iamashwin99/Proj14/README.md

# Proj14
Project work for Microprocessor and Interfacing Course. Design of a Keypad based Door Security Control on a 8086 microprocessor.
