iamashwin99/Proj14/Design.pptx

## DOOR SECURITY CONTROL SYSTEM Submitted by: Group 14

Group Members
- Ashwin Kumar K (2017B5A81034G)
- Sharvari Hedaoo (2017B5A70593G)
- Shreyas Nisal (2017B5A70310G)
- Vaibhav Chaudhari (2017B5A70834G)
- Vanshika Kapoor (2017B5A70624G)

## Slide 2

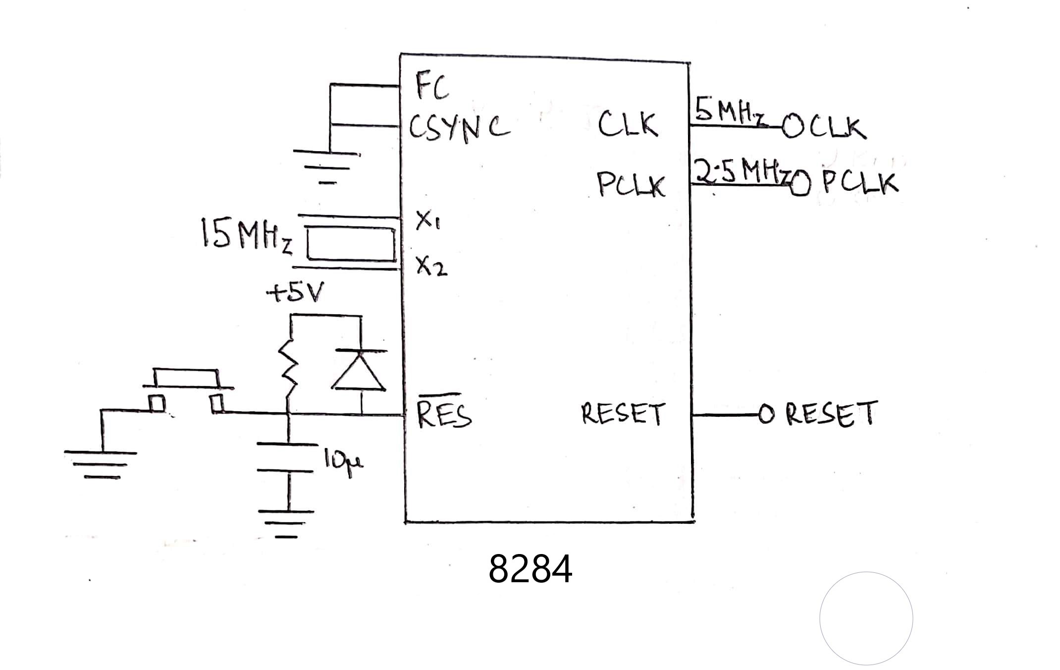
[picture p6: figure]

## Slide 3

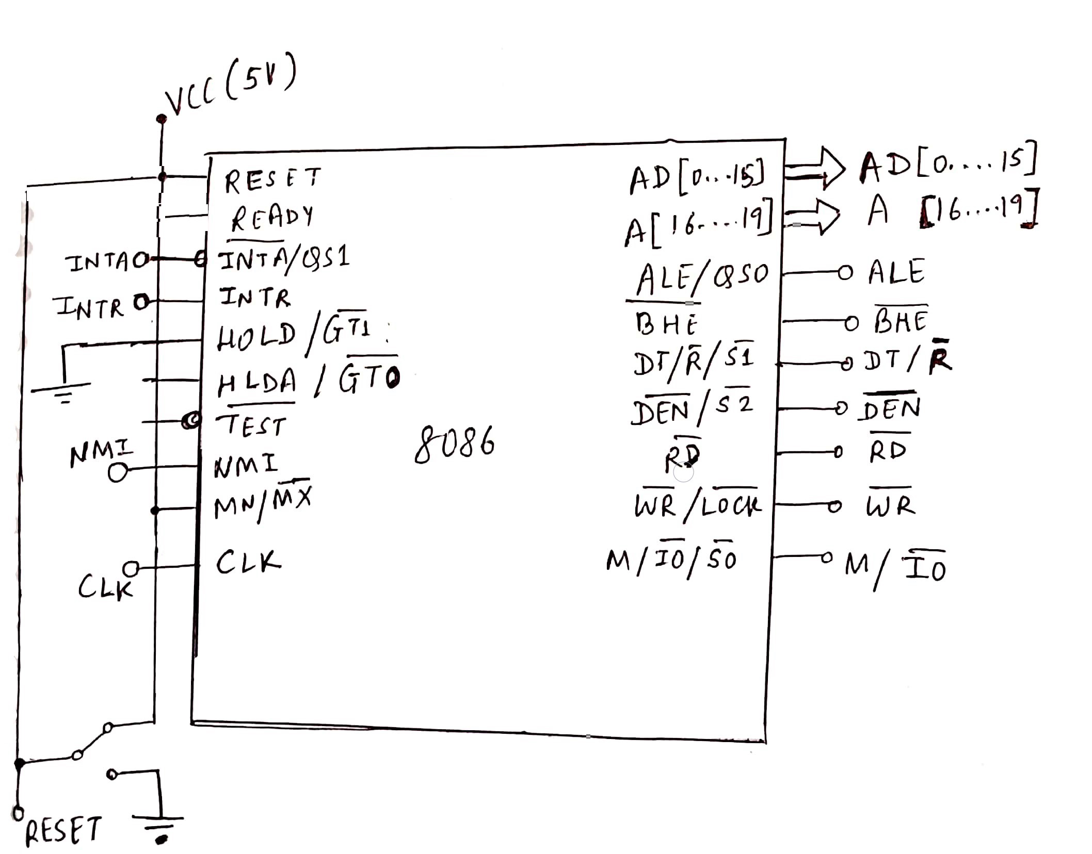
[picture p7: figure]

## Slide 4

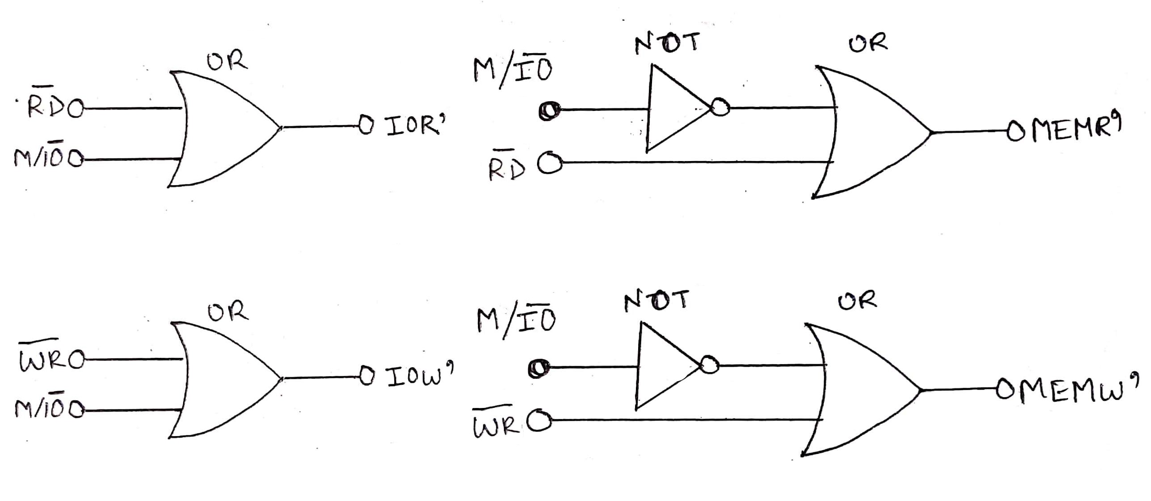
[picture p8: figure]

## Slide 5

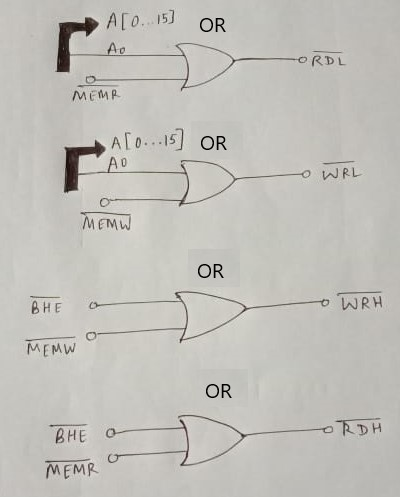
[picture p9: figure]

## Slide 6

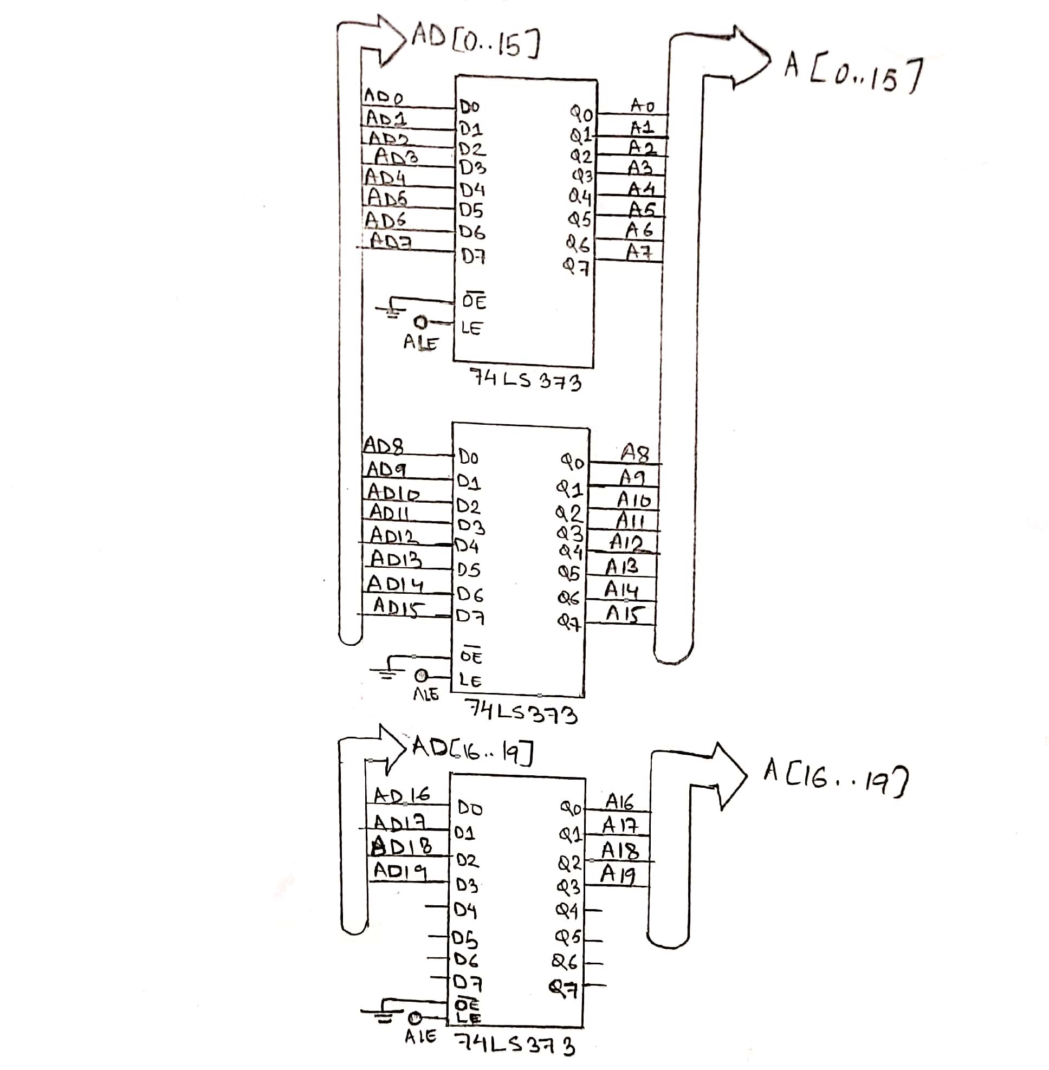
[picture p10: figure]

## Slide 7

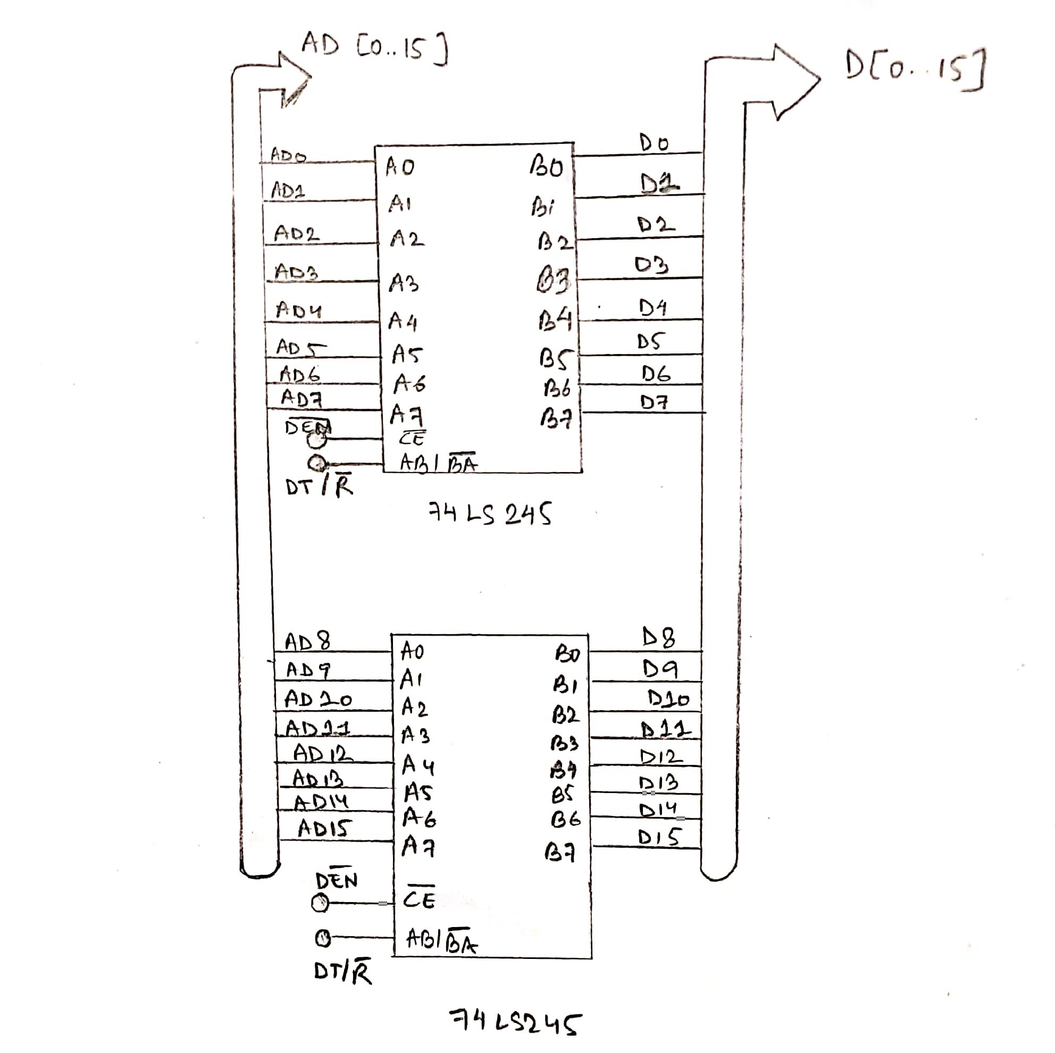
[picture p11: figure]

## Slide 8

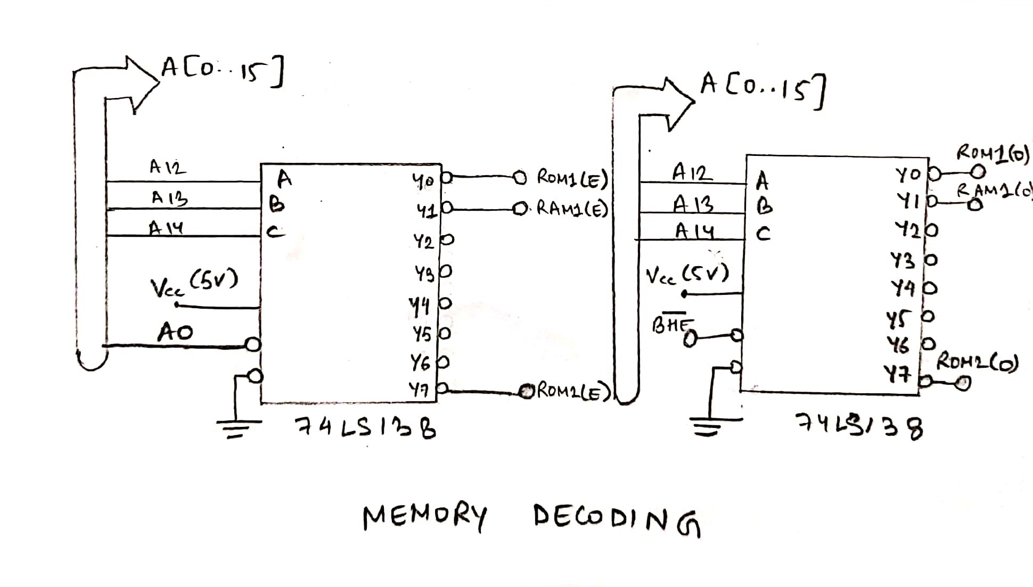
[picture p12: figure]

## Slide 9

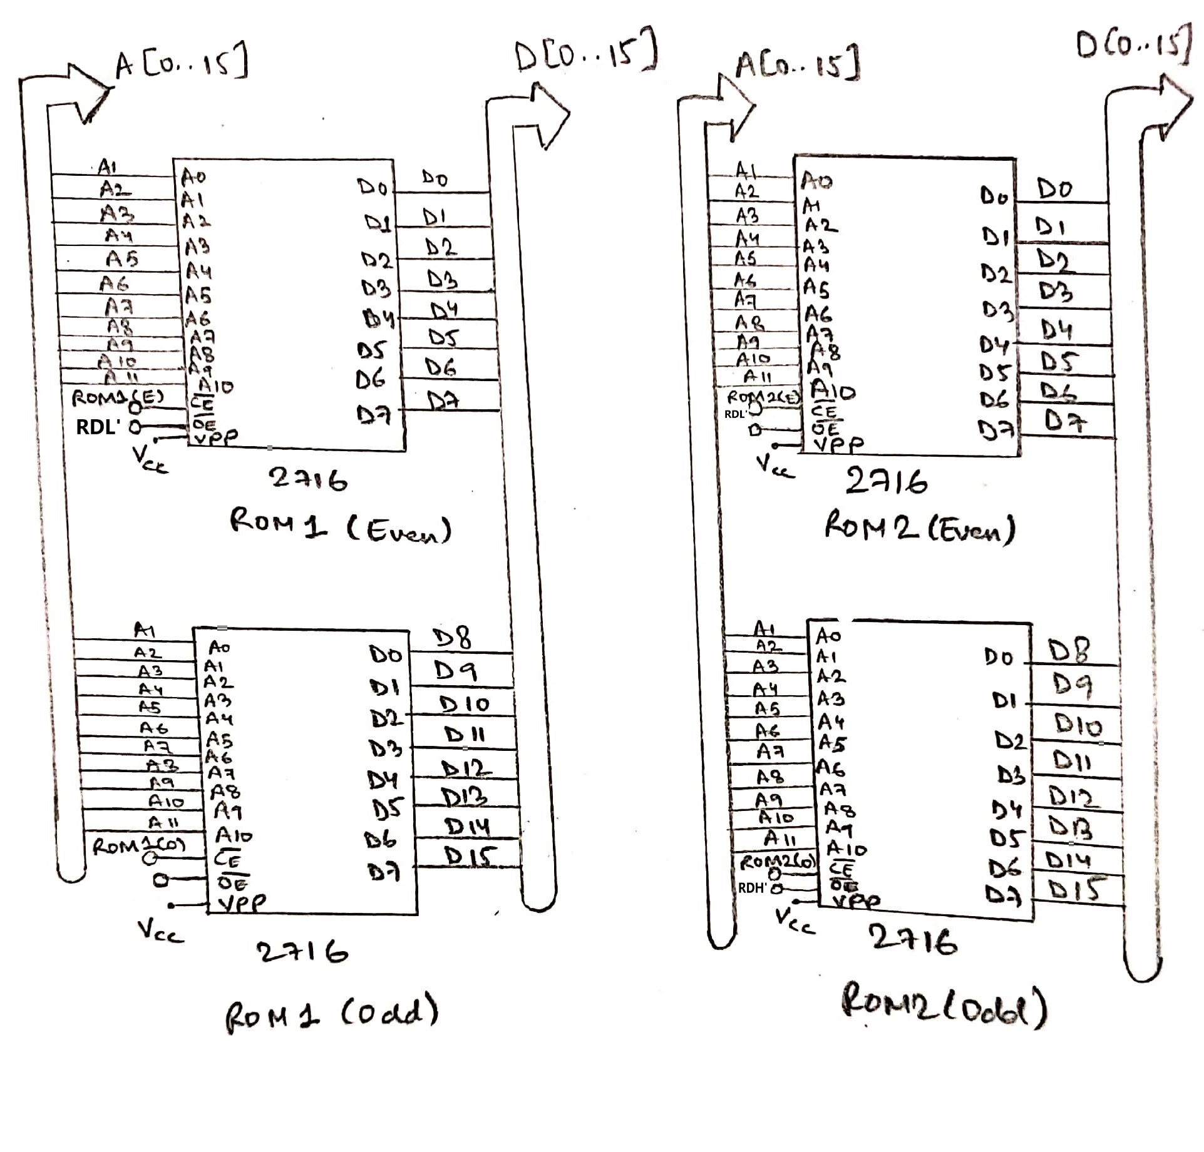
[picture p13: figure]

## Slide 10

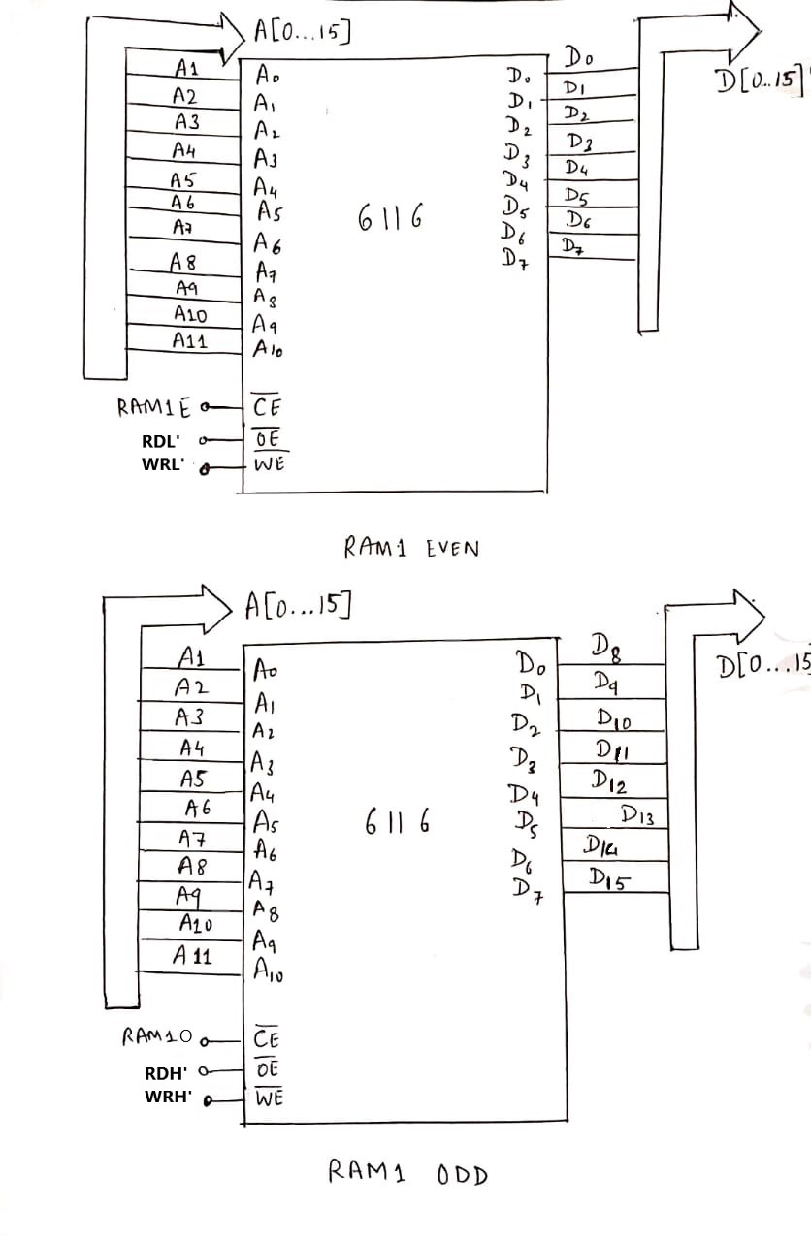
[picture p14: figure]

## Slide 11

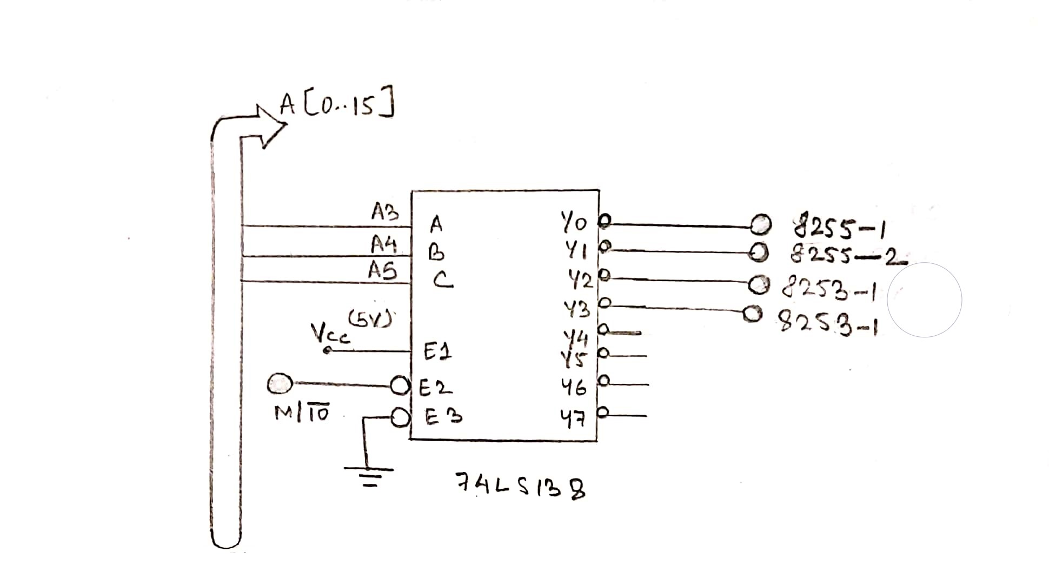
[picture p15: figure]

## Slide 12

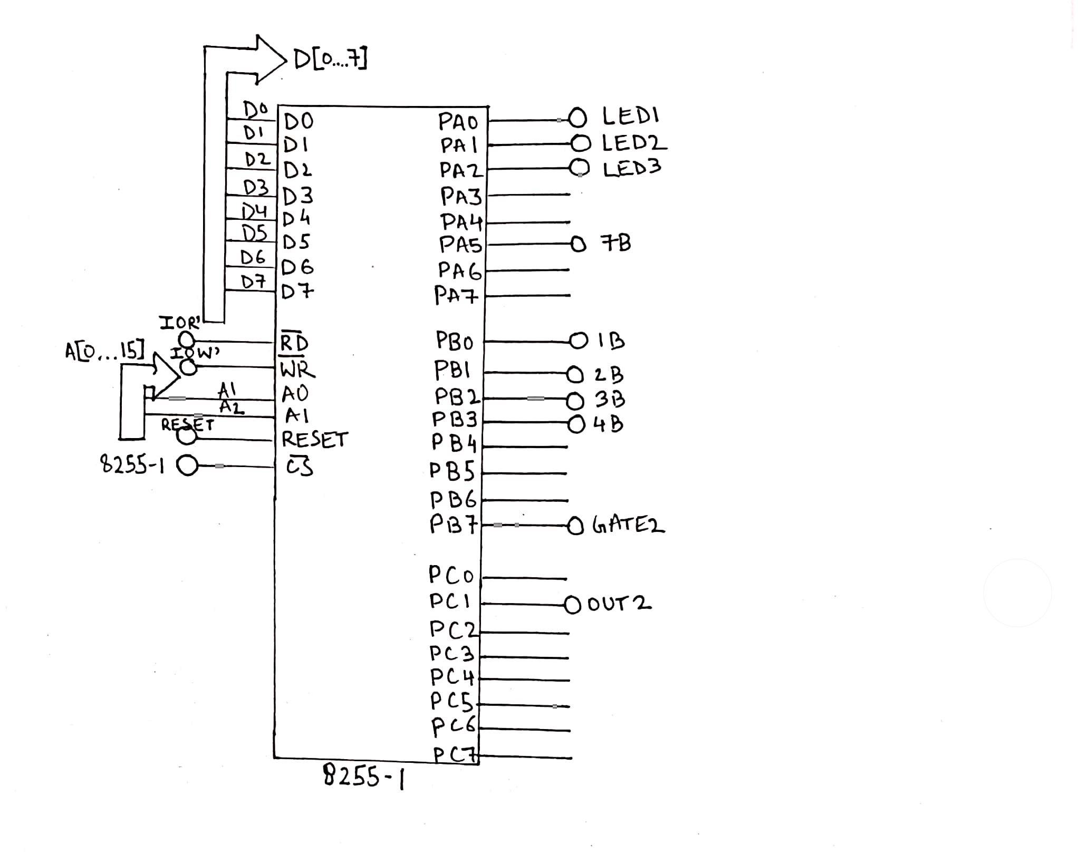
[picture p16: figure]

## Slide 13

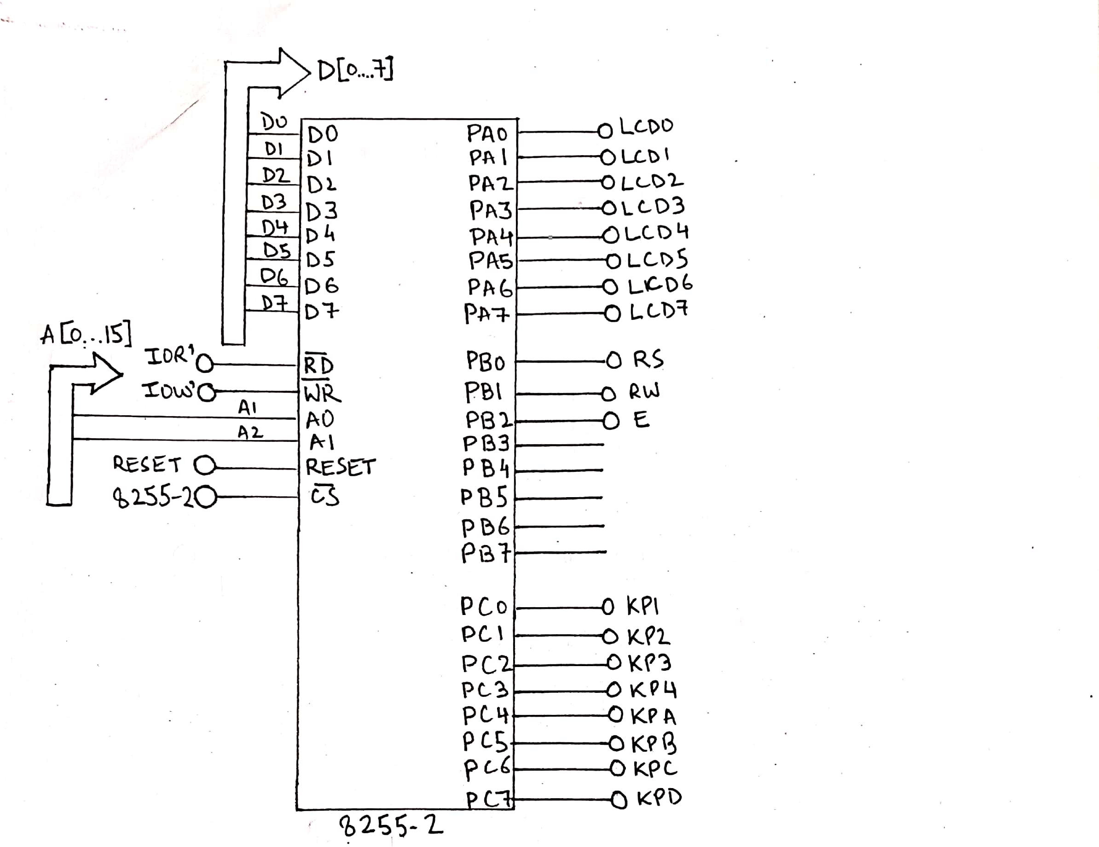
[picture p17: figure]

## Slide 14

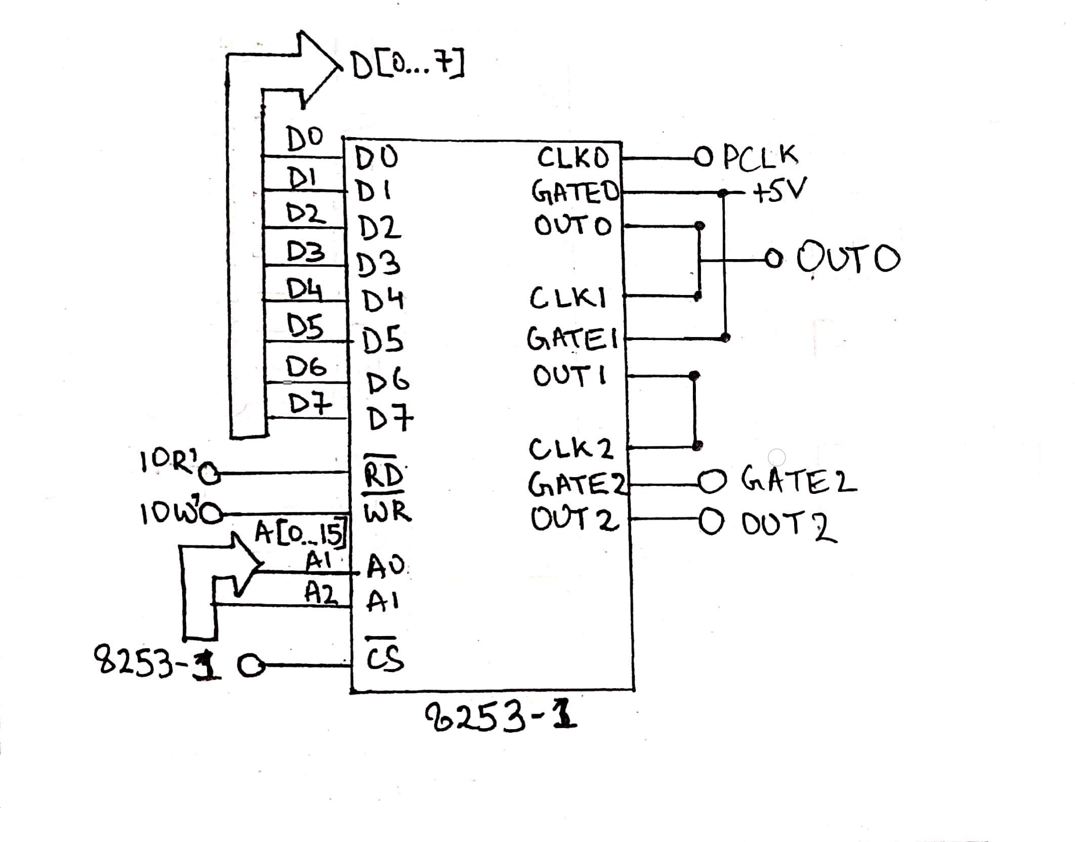
[picture p18: figure]

## Slide 15

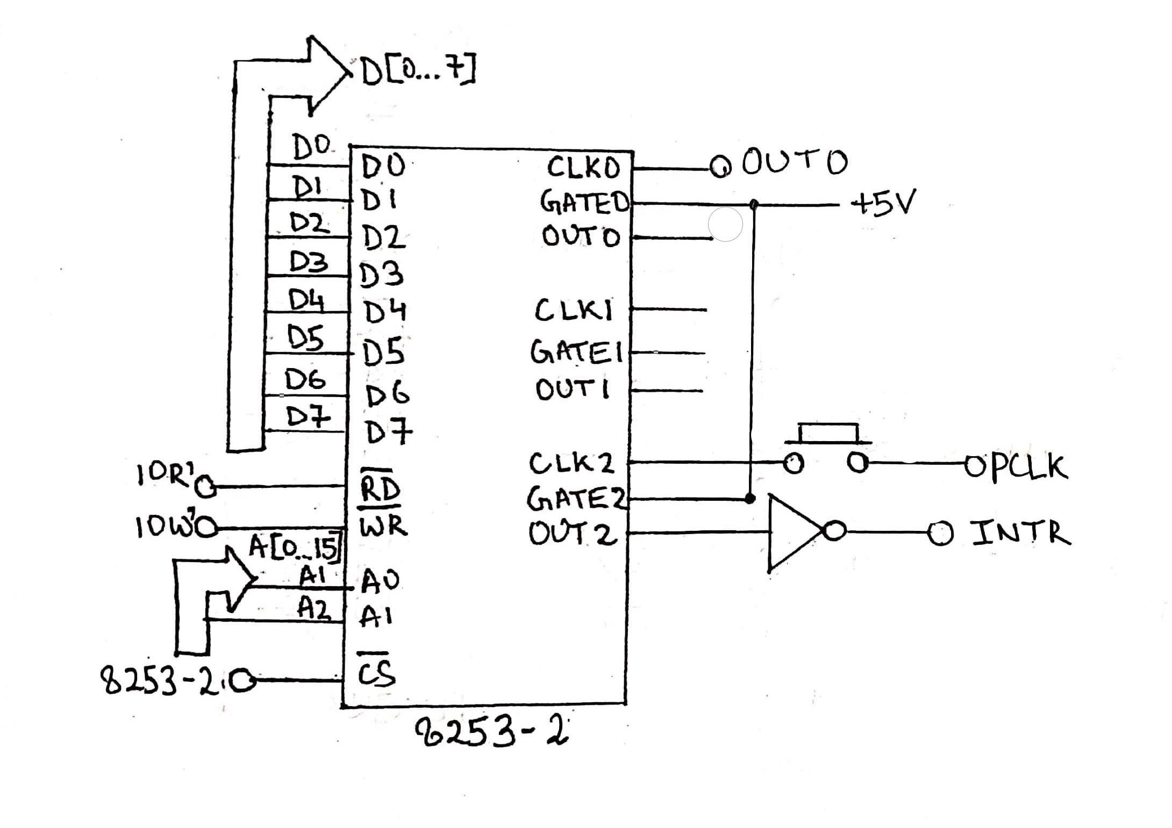
[picture p19: figure]

## Slide 16

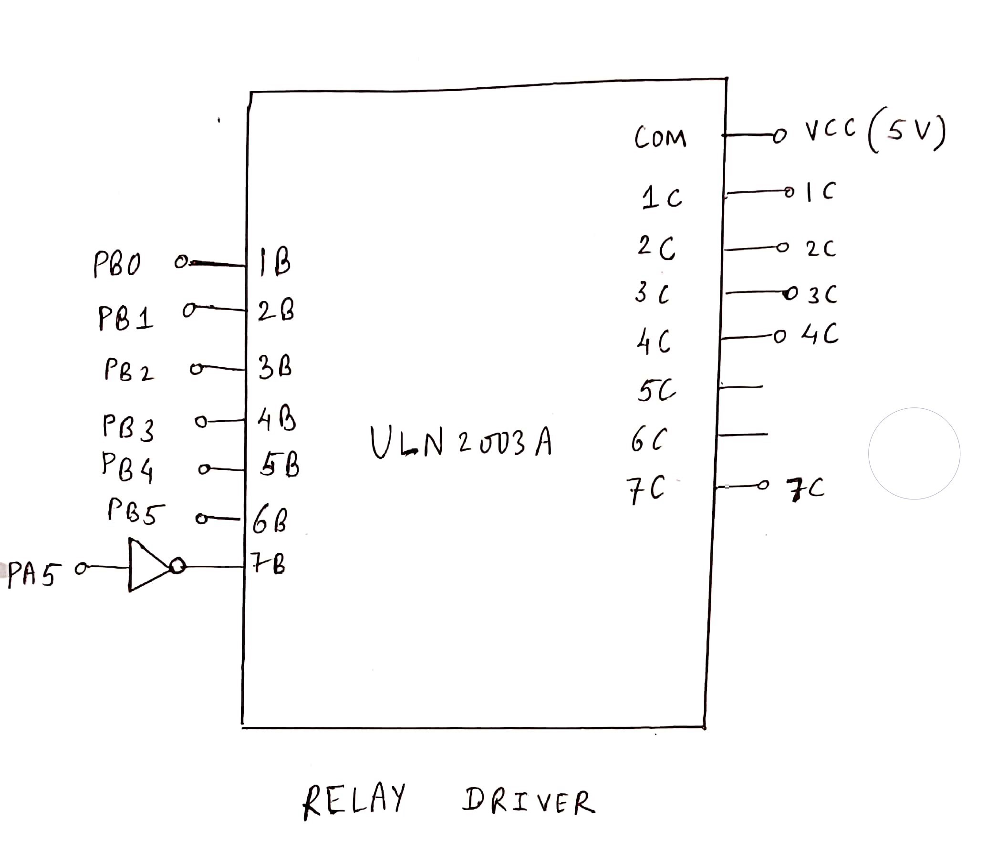
[picture p20: figure]

## Slide 17

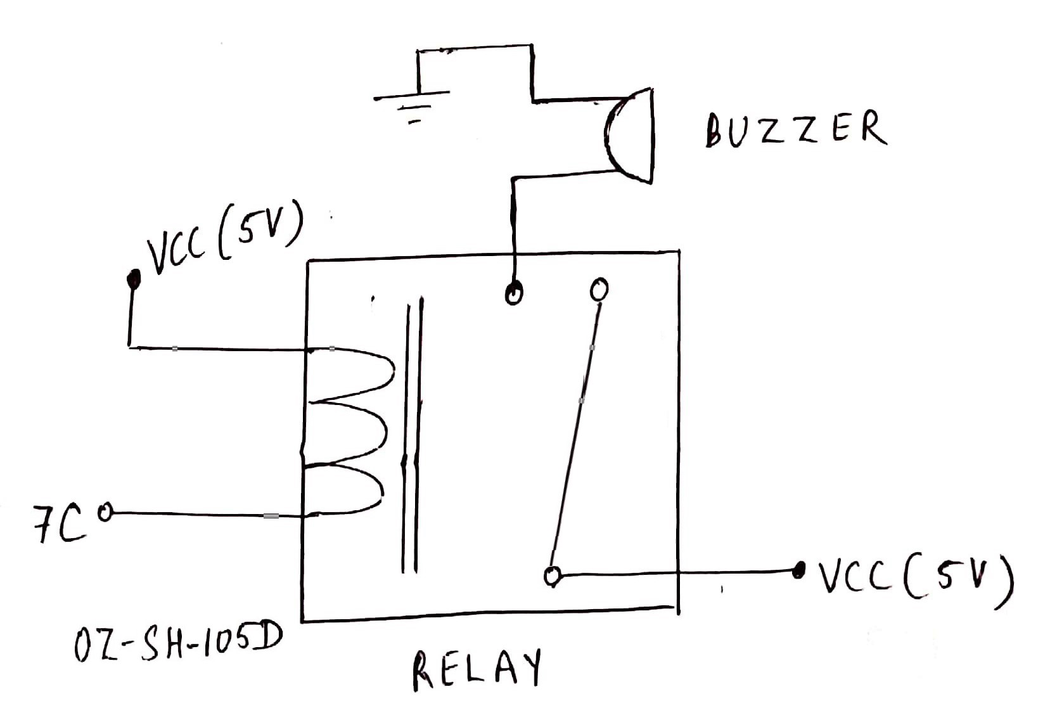
[picture p21: figure]

## Slide 18

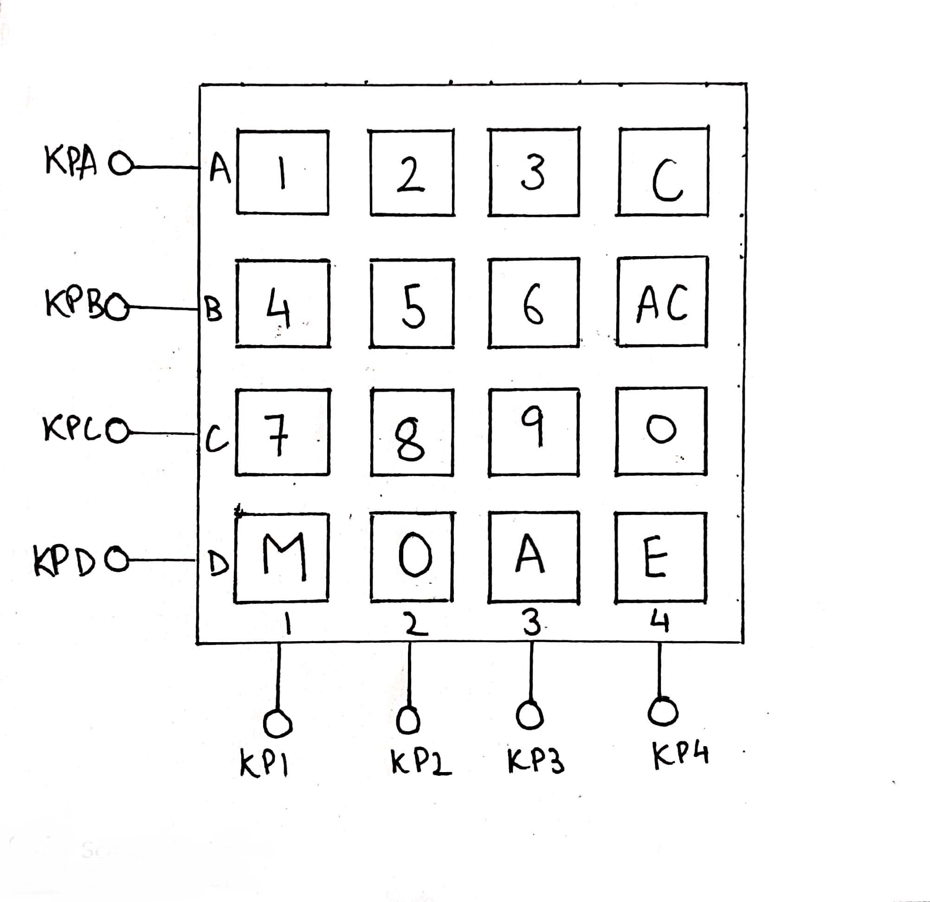
[picture p22: figure]

Keypad

## Slide 19

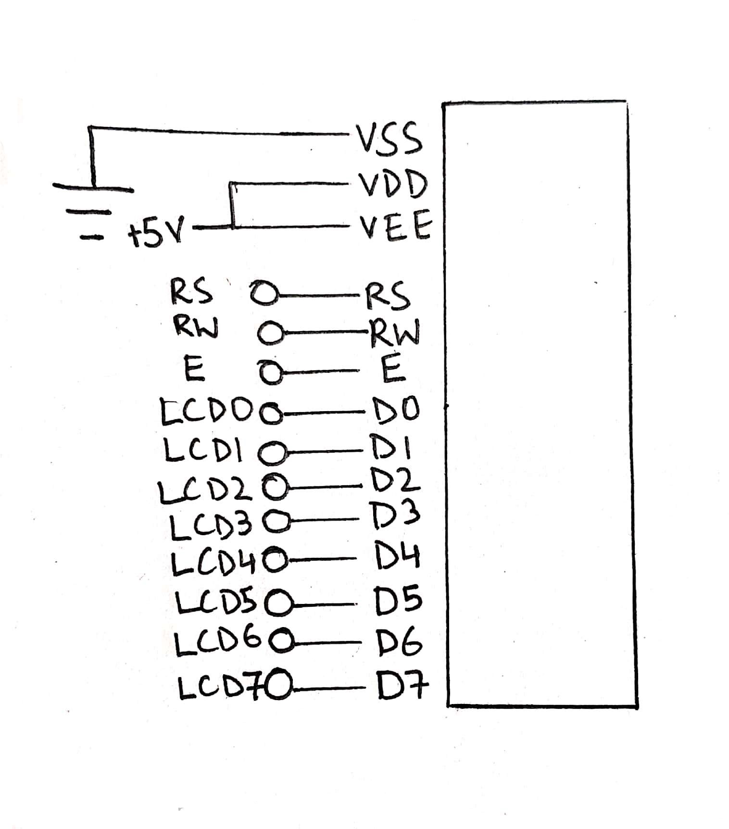
[picture p23: figure]

16*2 LCD Display

## Slide 20

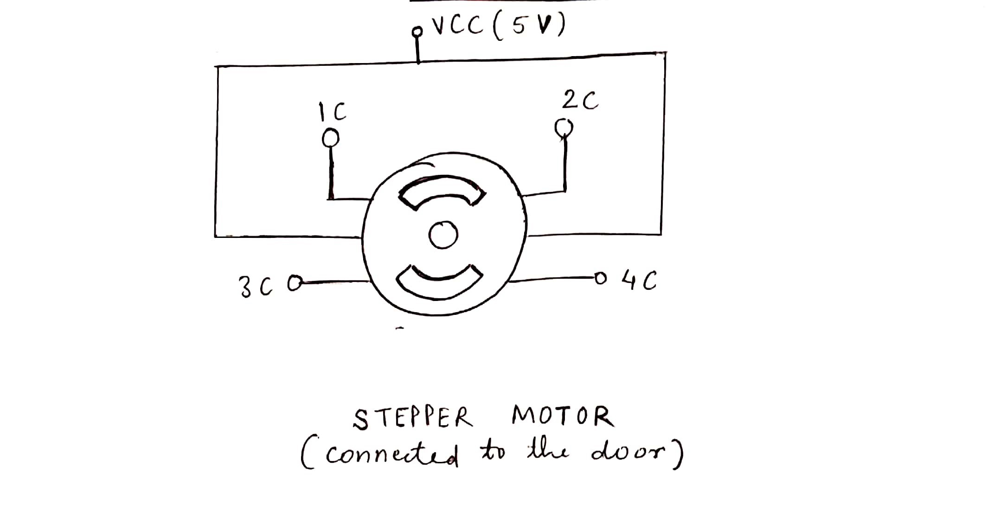
[picture p24: figure]

## Slide 21

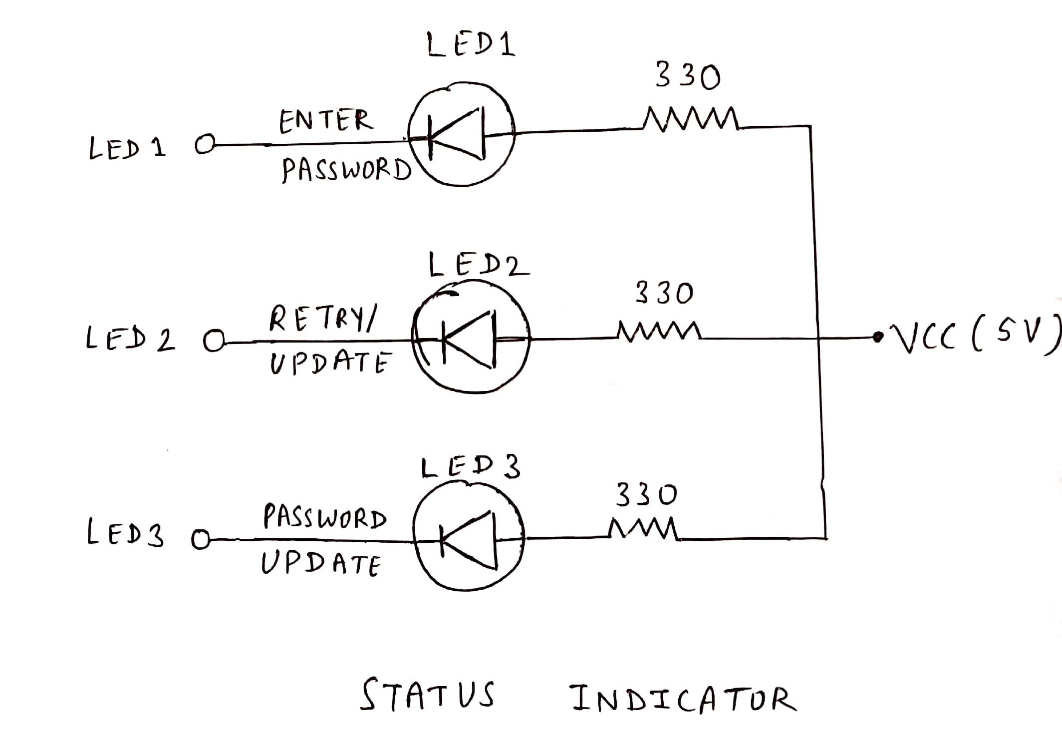
[picture p25: figure]

## Slide 22

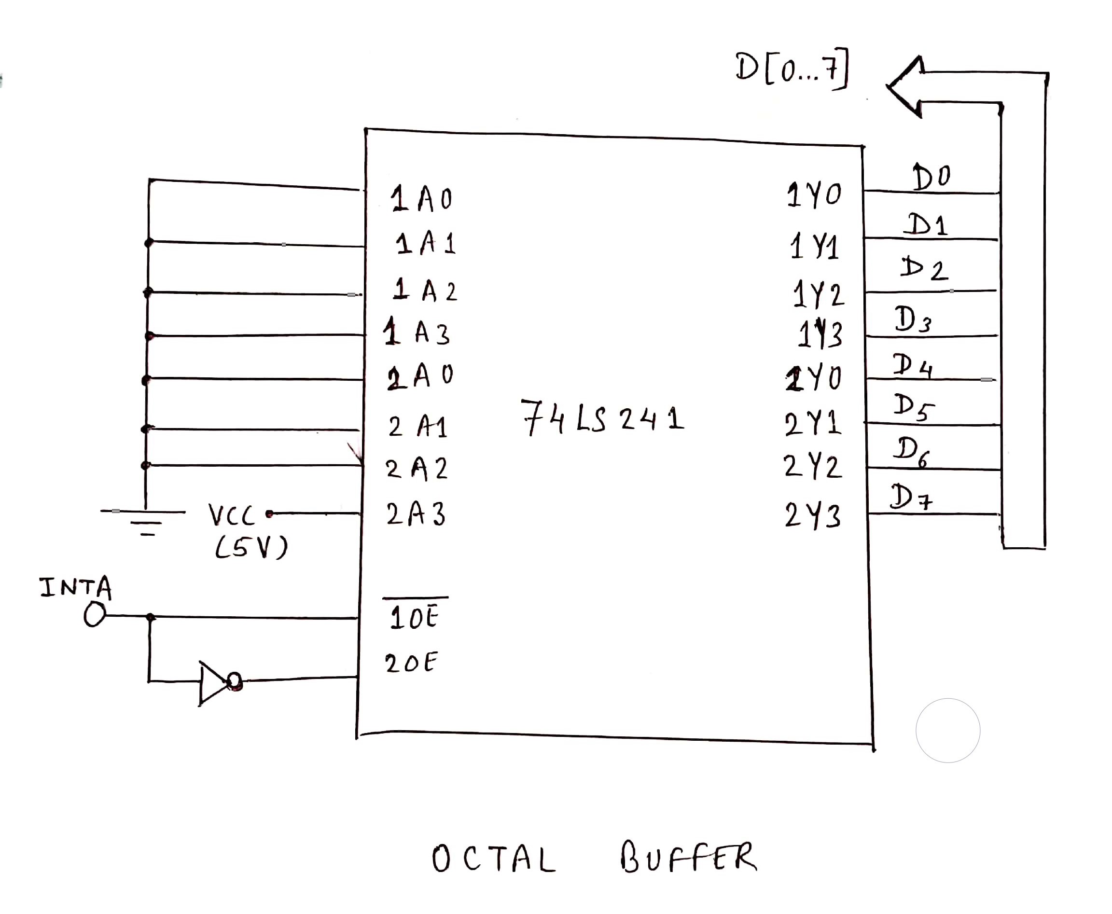
[picture p26: figure]
