iamashwin99/Proj14/Schematic_final.pdf

U12

U13

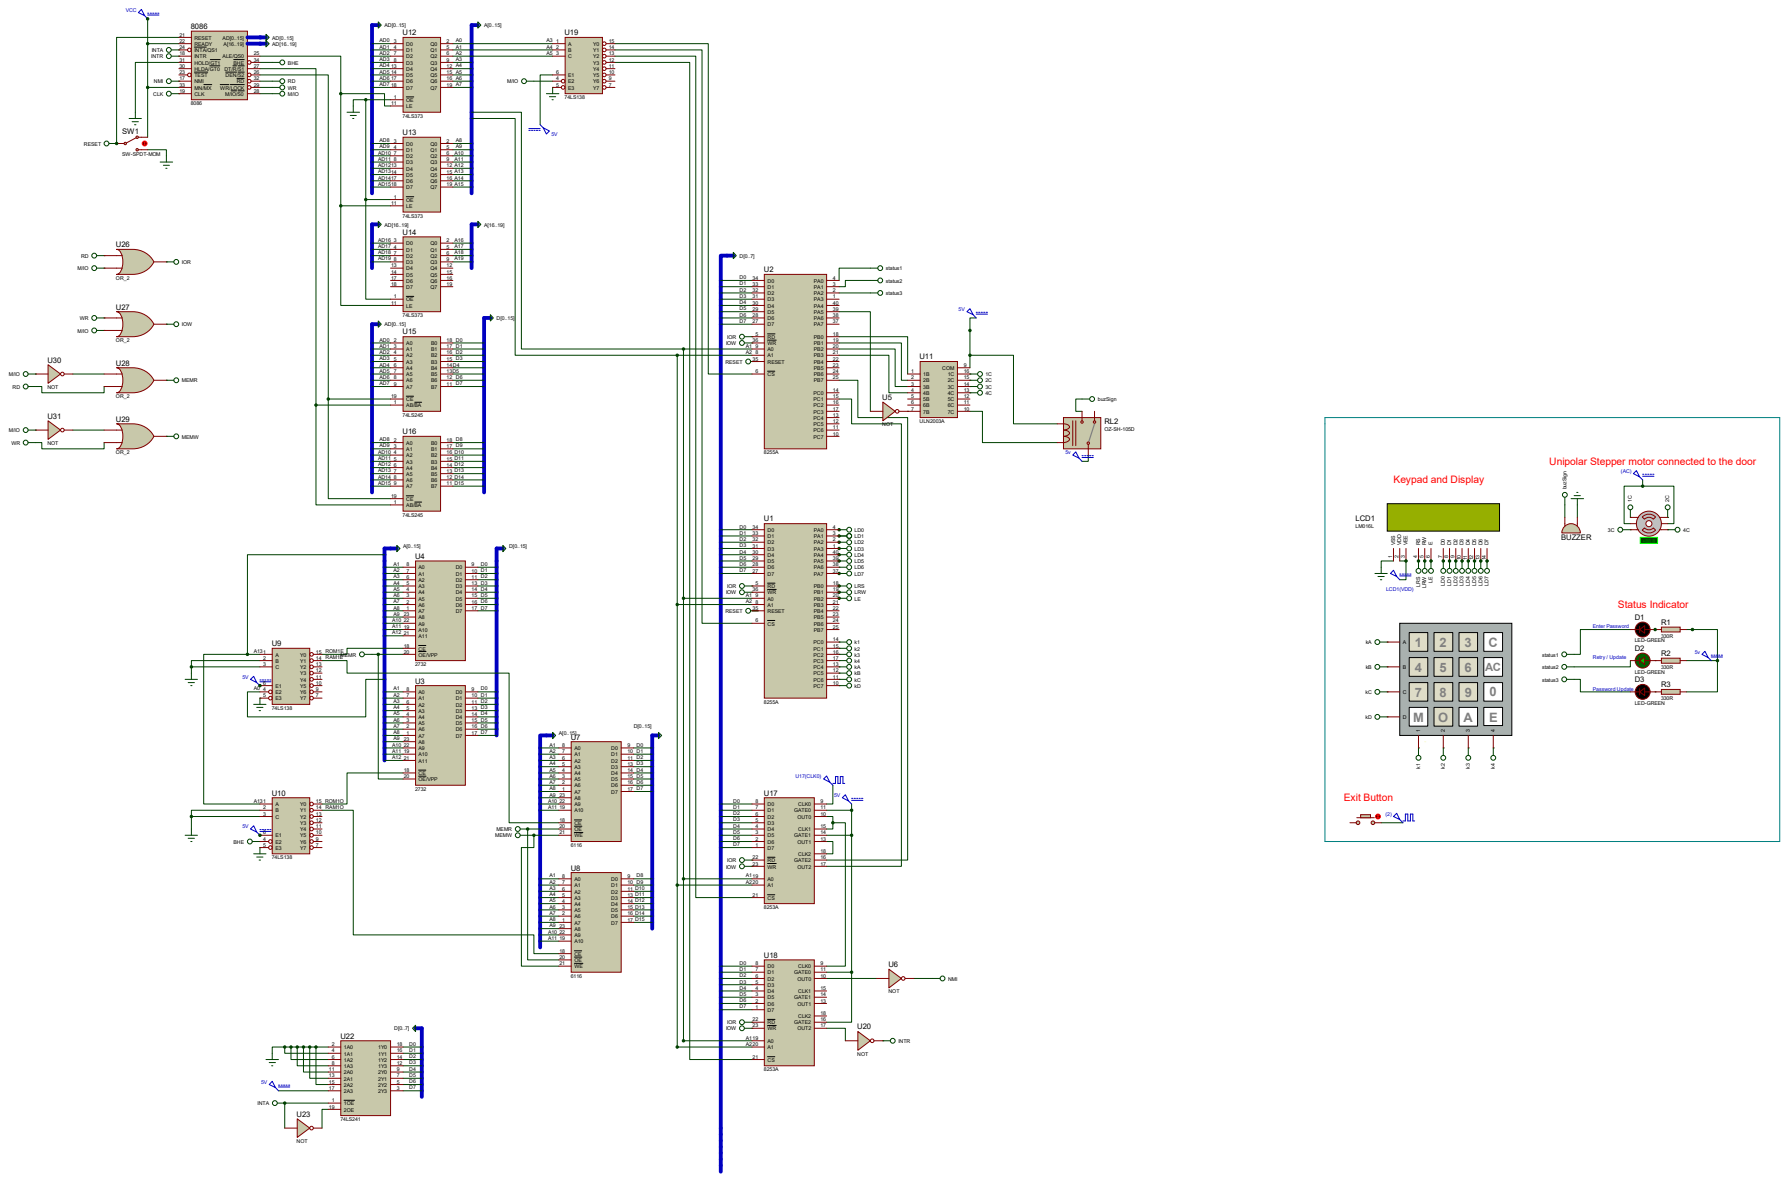
[picture p27: page 1]

Unipolar Stepper motor connected to the door
