iamashwin99/Proj14/(list of files, drawings)

Other design files:
Proj14_Final.pdsprj
